ivanshalashilin/Cavity/README.md

# Scanning transfer cavity lock MSci project
## Ivan Shalashilin and Jacob J. J. Edginton

Writeup tutorial and code of how to use the scanning transfer cavity lock (STCL) for the next
set of students. This readme outlines important knowledge 

# Experimental setup

The STCL setup is as follows (parts list at the end):

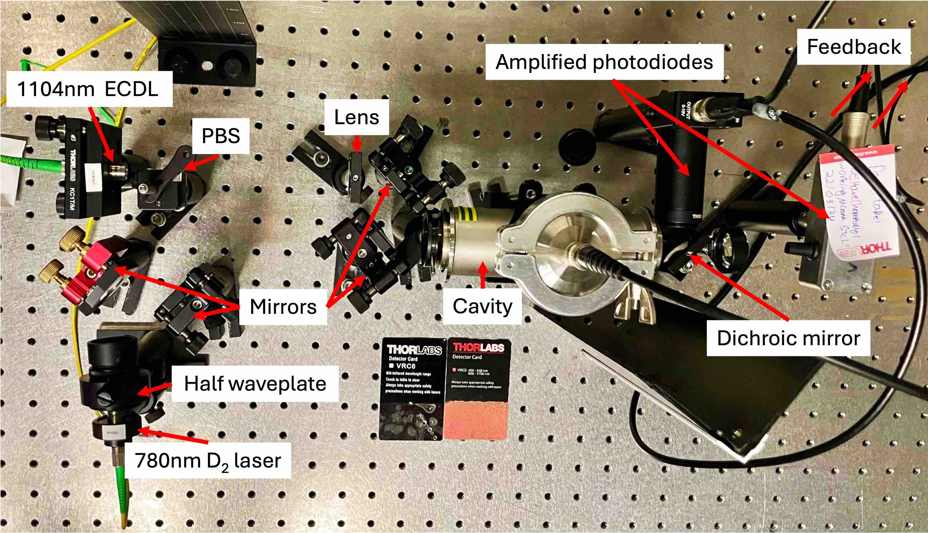
[picture p1: assets/cavity_setup_annoted.jpg]


0. Set up the optics as in the diagram (except the dichroic)
1. Fibre light from 1104nm and 780nm into fibre collimators
2. Pass 780nm light through half waveplate. Rotate waveplate until it is reflected at the
   polarizing beam splitter (PBS)
3. Turn on function generator, amplify the signal, and scan the cavity with a
   sawtooth/triangle wave at $\sim$ 5-15Hz
4. Couple 1104nm into the cavity (alignment tips below), until signal is maximized. Monitor output with amplified
   photodiode on an oscilloscope
5. Align 780nm into the cavity via the PBS
6. Align dichroic mirror and second photodiode to split 780nm onto the second channel

# Peak detection

Once both lasers are aligned, the peak detector boxes need to be set up - these provide
a TTL (digital) pulse for use in locking. This is done as follows:

1. Send each photodiode output into a separate peak detector box
2. Plug preamp monitor and output into scope, adjust the box until signal is desired
   (this step is finnicky)
3. Repeat 2 for diff gain and threshold
4. Change pulse width to desired value (see below)

The schematics/circuit diagrams for the peak detector boxes are available in the CCM.

## Arduino

The Arduino Due takes 4 digital inputs - TTL 780nm, TTL 1104nm, rising and falling edge of
function generator scan trigger. There are two digital outputs for feedback to the cavity and
the laser. The Arduino is set up as follows:

(pin values are arbitrary. Choose whatever corresponds to the code/is convenient)

1. Connect the 780nm TTL into pin 50 and the 1104nm TTL into pin 46
2. Split the function gen trigger signal and connect to pin 30 and pin 26
3. Connect the 1104nm feedback to DAC0 and the cavity feedback to DAC1
4. Connect low pass filters (cutoff $\sim$ 1000 Hz) on the analog outputs
5. During operational STCL, combine the amplified function generator and cavity feedback with the
   voltage summer, then send to cavity
6. Adjust offset on function gen until the cavity is scanning a FSR with an 1104nm peak in
   the middle of two 780nm peaks
7. Run Arduino code

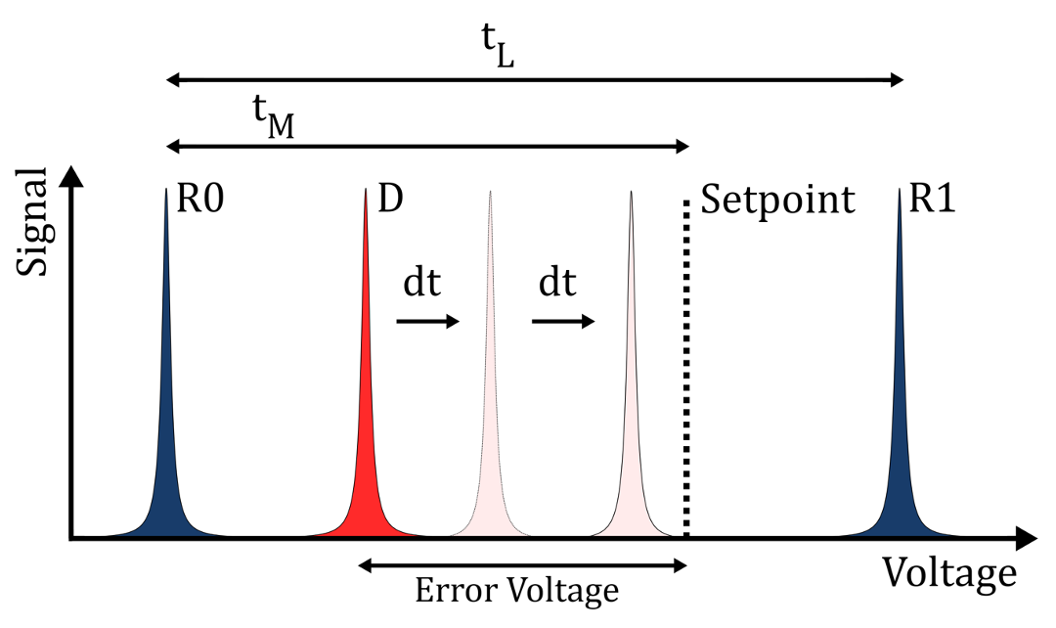
[picture p2: assets/STCL_algo_cartoon.png]


# Arduino algorithm

## High level

Check this paper for a good explanation: [Fast scanning cavity offset lock for laser frequency drift stabilization](https://pubs.aip.org/aip/rsi/article-abstract/81/7/075109/924409/Fast-scanning-cavity-offset-lock-for-laser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)

## Code specifics

This repo contains the STCL file `STCL_CCM_final.ino`, which works as follows:

  `setup()` 
  - 
-  Enables output to the analog pins
-  Enables the serial port for data logging
-  Creates interrupt pins for the rising and falling scan trigger edge 
- Enables the input to digital pins for 780nm and 1104nm
- Updates `time_previous` to the current time using `micros()`

`enable_input()` and `disable_input()`
  - 
- Interrupt functions associated with the
  rising and falling edge scan trigger - flip bools in the main loop 

  `loop()`
- 
- The loop begins by waiting until the rising edge, triggering `enable_input()`, which enters into the state
    machine `on_ttl_high`
- The code enters `while(!master_1_found)`, which continuously reads the master pin
    and stays inside the while loop until there is a high signal on the master pin. Once
    this is true, it records the time and flips the bool `master_1_found`
- Previous step is repeated with the bools `slave_1_found` and `master_2_found`

- Once all 3 peaks have been found, the code computes a PID 1104nm laser feedback (see theses for a
  detailed explanation)

-  Next, the code waits for the falling edge interrupt, and computes the cavity PID
   output. Both are then sent at the same time on the
  analog pins to the cavity and 1104nm laser. 

  - The loop resets and waits for `enable_input()`

If a peak is missed on the scan, the Arduino loops over the pin until `disable_input()`
is triggered, resetting the loop entirely, and no correction
is made.

# Alignment

Aligning a cavity is an art, not a science. Here are some tips:

1. Place the alignment mirrors as close as possible to the cavity
2. Always use a lens, *before* the alignment mirrors. This way changing the alignment
   doesn't mess with alignment along the lens
3. Use q-parameter software such as GaussianBeam to determine where the lens should go,
   accounting for the first cavity mirror
4. Centre the mirror threads before alignment
5. Coarsely adjust into the cavity by manually moving/rotating the mirrors before using
   the threads
5. Ensure the beams are central on the face to avoid clipping
6. Always lens the signal onto the photodiode

In his thesis, John Barry mentions an iterative method of aligning which involves
changing the mirror length. We didn't do it this way but reading his thesis may be useful.

# Data acquistion (DAQ)

Data logging was used extensively in the project. To monitor cavity signal, we used a
PXIe and NI DAQs interfaced by Labview. This is found in the folder `Labview`. The PXIe has a breakout board with many pins, the board guide that matches up the names of the physical pins and the physical channel names you'll see in LabView is available from [NI's website](https://www.ni.com/knowledgebase/attachments/A1866E353248893C862571BD000CEB62_SCB-6820653X.pdf).

(note for Jacob: write up Putty + Labview)

## LabView Program

To collect photodiode voltage and Thermocouple temperature a custom built LabView software was created. To avoid large files and memory overflow the program saves collected data periodically in separate files rather than in one file all at once. 
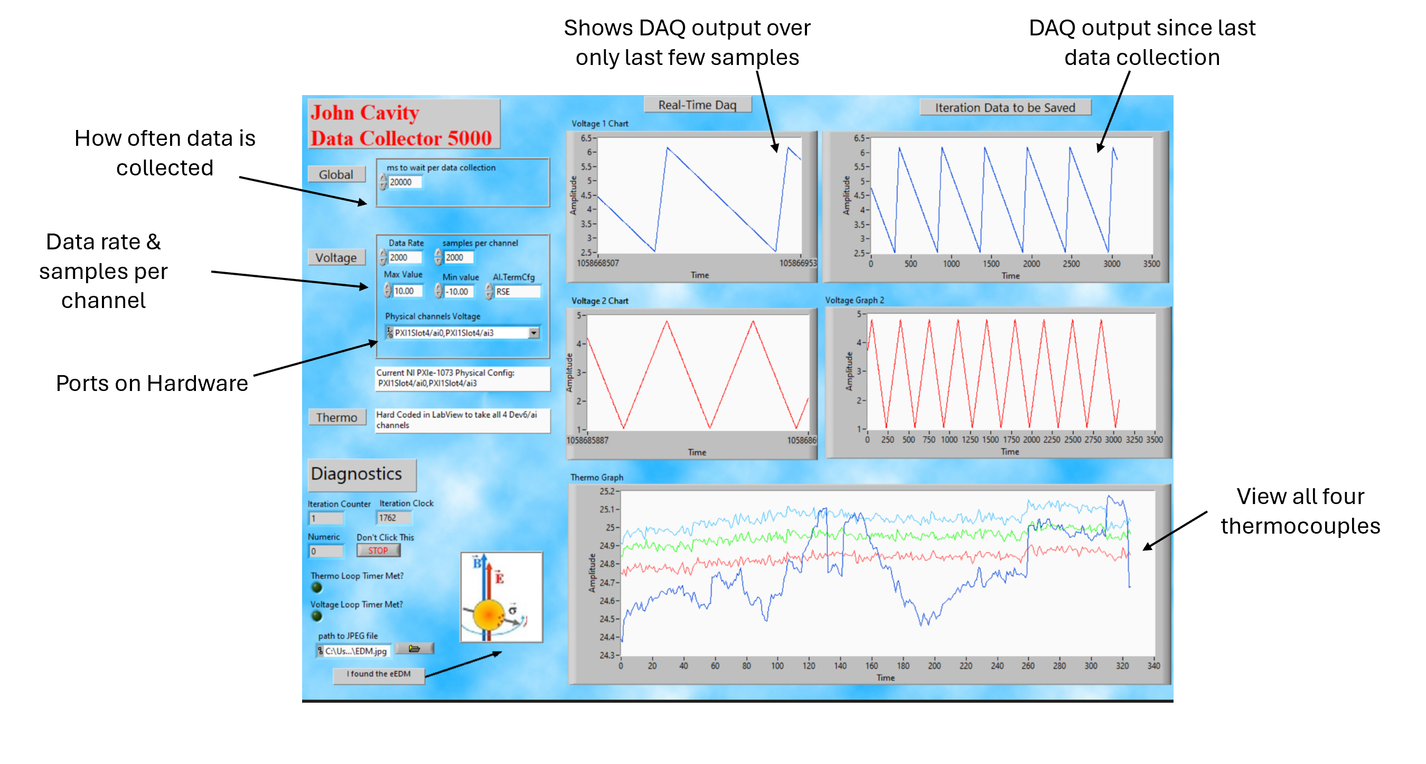
[picture p3: assets/LabViewUI_labels.png]

The above image shows what the UI for the program looks like during operation. To set up data collection:
- Choose two PXIe physical channels to view/record. Typically for the STCL this is the function generator and the photodiode.
- Set the desired length in milliseconds between data collections.
- Set the `Data rate` and `samples per channel`. Making the rate too high can cause issues with the signal.
- Generally always leave the max/min at 10/-10 and the `Al.TermCfg` to `RSE`. 
- When you first run the code you will be prompted to add an image. Adding any image file will work (this is a deprecated part of the code and should be removed).
- The iteration counter keeps track of how many times the data has saved.
- The file paths to save the photodiode voltage and thermocouple temperature txt **must be set manually** in the LabView code. 

General notes about the LabView software:
- There are no settings for the thermocouples as these were set manually in the LabView code. They may be changed by editing the code directly. 
- The "Current NI PXIe-1073  Physical Config" is an old placeholder (may be ignored).
- This code is quite rudimentary. If all you want is photodiode/temperature data it will work but we would recommend building a new program in LabView from scratch that is more optimized (this one uses a double for loop...)

## Putty
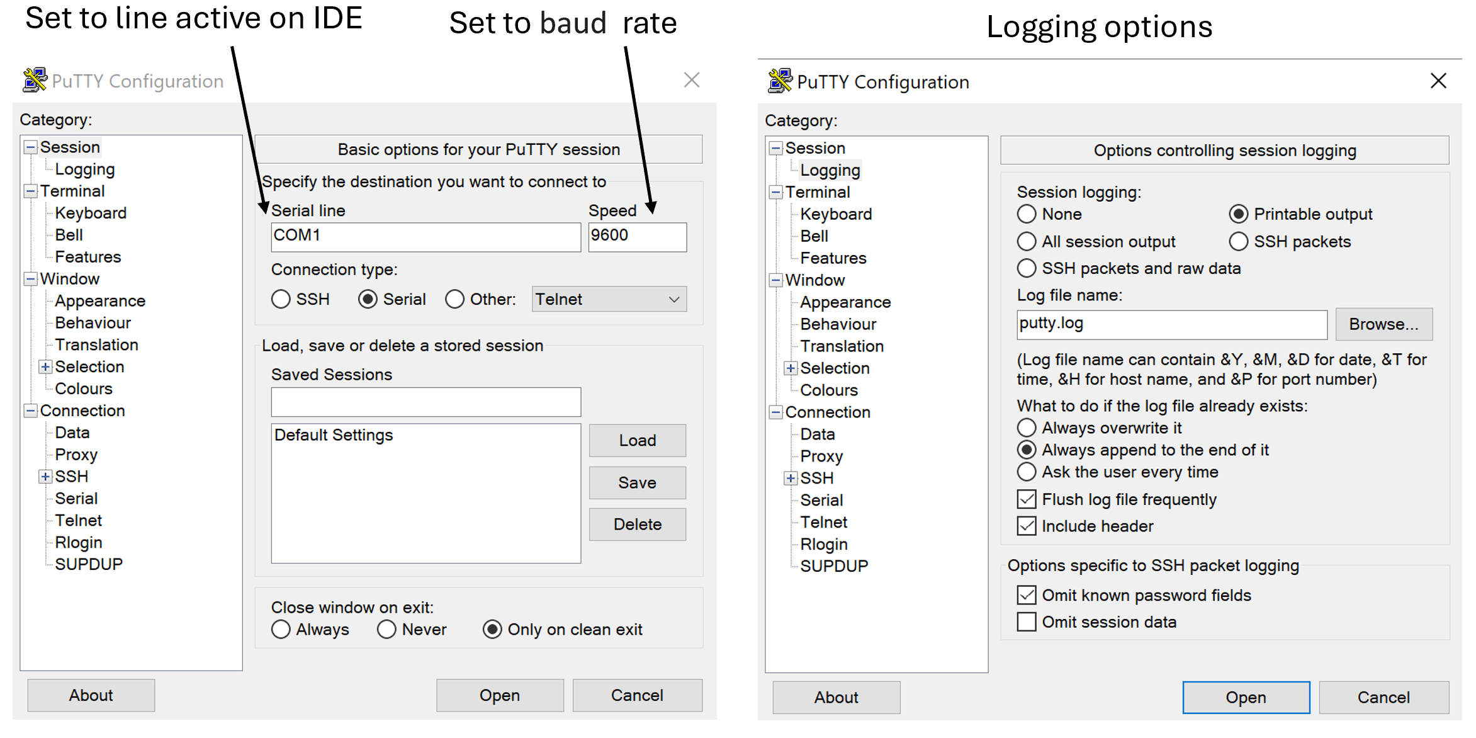
[picture p4: assets/putty.png]

To collect data from the Arduino Due (e.g. times of peak detection) we used the software Putty, available for [download online](https://www.putty.org). The Arduino must be plugged into the computer for Putty to work. We recommend using the official [Arduino IDE](https://www.arduino.cc/en/software) whilst trying to log data. The process for logging is as follows:
- Specify the COM line and baud rate in Putty (this information will be visible in the Arduino IDE).
- Set logging settings (location, name, etc.)
- Begin Putty session.
- Activate Aruino code.

# Electro optical modulator (EOM)

Throughout the project we used an EOM to determine the cavity nonlinearities and
concluded they are a material property of the PZT. There is currently an EOM on our
bench with a resonant frequency of 94.9MHz that can be inserted between the PBS and
lens. We used a vector network analyser to determine the resonant frequency which can be
found in Blackett. The EOM is driven by a voltage controlled oscillator (VCO) amplified
by an RF amp.

# Improvements

With our setup the 1104nm stayed lock for 1.9 days with a spread of 1.6 MHz, and there
are plenty of areas for improvement:

- **Amplified photodiode**: The transmission on the current cavity mirrors is low, even on resonance (James Almond [PhD Thesis](https://www.imperial.ac.uk/centre-for-cold-matter/publications/theses/) 2017 page 94, footnote 11). We found that a reliable signal for STCL was only possible with amplified photodiodes. 

- Hardware interrupts: Currently the peaks are found by continuously looping over the
  pins. Instead, the peak detection needs to be done with a hardware interrupt,
  effectively increasing the detection resolution, and allowing for more corrections per
  second. Our current setup only optimally allows for correction speed of $\sim$ 5Hz, even though
  we were driving the cavity at 15Hz. With interrupts, we believe this could go $\sim$ 100-1000Hz

- The data types in the code are **not set correctly to save putty data**. This does not prevent the STCL from running. The variables that are initialized as `unsigned long` should be changed to another type e.g. `double`.

- Auto initialization: The function generator DC offset needs to be manually adjusted
  for the correct locking configuration (780nm-1104nm-780nm). A better method would be to scan
  the offset to find an ideal configuration and determine the setpoint from there.

- Peak detector TTL output: the peak detector boxes take all the photodiode signal, so it can't be
  split to observe on both the photodiode and the scope at the same time. Maybe some
  resistors are needed.

- **Different cavity mirrors**: the cavity mirrors (Layertec 103950), which make a cavity
  with very low transmission, and has been studied before by James Almond ([PhD thesis](https://www.imperial.ac.uk/centre-for-cold-matter/publications/theses/) 2017,
  page 94, footnote 11)

- Dichoric mirror and PBS: the dichroic mirror has high absorption, significantly
  attenuating the 780nm reflected beam.
  
- Higher power: 0.4mW is passed into the cavity at 780nm. With a 50$\Omega$ input impedance the entire
  signal was attenuated which is not sufficient to
  perform a proper finesse calculation. Using a more powerful beam allows allows for
  smaller resistor

- Ringdown measurement: ask CCM member Jonas for more information. We attempted this but didn't have enough
  power/the AOM was not quick enough (unsure). See [AOM](/assets/project/AOM.png) for the experimental set-up we tried. 

- ECDL feedback: in our setup we used an amplifier to send the feedback signal to the
  ECDL, which ended up being our main source of error. This can be removed, and was only
  used as a proof of concept to scan a larger range in frequency space.

- Peak detector box accuracy and variance: the output TTL has a large variance and a
  systematic shift from the true peak centre. This should be characterized and
  investigated.
  
- Peak detector box issues: 10mV noise on the output and grounding issues

- New cavity: The current cavity quartz is cracked, and possibly not the right length.
  We cut and glued a new one but maybe used too much glue inside the cavity, meaning the
  thermal compensation won't work properly

- Hermetic seal: we believe the seal may be slightly leaky, which according to John
  Barry leads to a drift of many, many FSRs.

- Laser locking: during long-term (3 days +) runs to establish thermal performance the laser may unlock. This makes it difficult to seperate thermal drift from laser drift. Ensure the laser is locked before taking thermal data.

- Applying heat: we applied heat as a step change (e.g. 10 degrees). It may be more useful to step the temperature in small increments instead.  

# Parts list 

## Cavity
 
- Cavity mirrors - [Layertec laser mirror 103950](https://www.layertec.de/en/shop/datasheet-103950/?cur=USD)
- KF-50 vacuum casing
- PZT actuator – [Noliac NAC2123](https://www.mmech.com/images/stories/Standard_Products/Noliac_Actuators/Ring_Actuators/NAC2123.pdf)

## Electronics

- Voltage summer (homebuilt)
- Function generator
- Amplifiers
- Lowpass filters (homebuilt)
- Electro optical modulator (EOM, homebuilt)
- Arduino Due microcontroller
- PXIe data acquisition box
- **Amplified** photodiodes x 2 
- Peak detector boxes (homebuilt, find these in Blackett bay 1)

## Optics

- 780nm D2 Rb laser
- 1104nm ECDL laser
- Broadband mirrors x 4 – [Thorlabs BB1-EO3](https://www.thorlabs.com/thorproduct.cfm?partnumber=BB1-E03)
- Fibre collimtors x 2 – [Thorlabs
  F280APC-C](https://www.thorlabs.com/thorproduct.cfm?partnumber=F280APC-C) (one of them
  may be B coated rather than C)
- Polarizing beam splitter
- f=150mm B coated lens (subject to change) – [Thorlabs LA1433-B](https://www.thorlabs.com/thorproduct.cfm?partnumber=LA1433-B)
- Half waveplate
- Dichroic mirror – [Thorlabs DMLP950](https://www.thorlabs.com/thorproduct.cfm?partnumber=DMLP950)
- Lenses for photodiodes (short focal length) x 2  

## Thermo 

- Varyac (find these in Blackett)
- Thermocouples
- NI Thermocouple DAQ
- Insulating foil

# Thermal
See the page [Thermal](Thermal.md) for detail on the thermal characterization of the cavity. 

# Misc.
If you would like any additional information of access to the data please contact the authors or the CCM.
