ivanshalashilin/Cavity/assets/LabView_UI.JPG

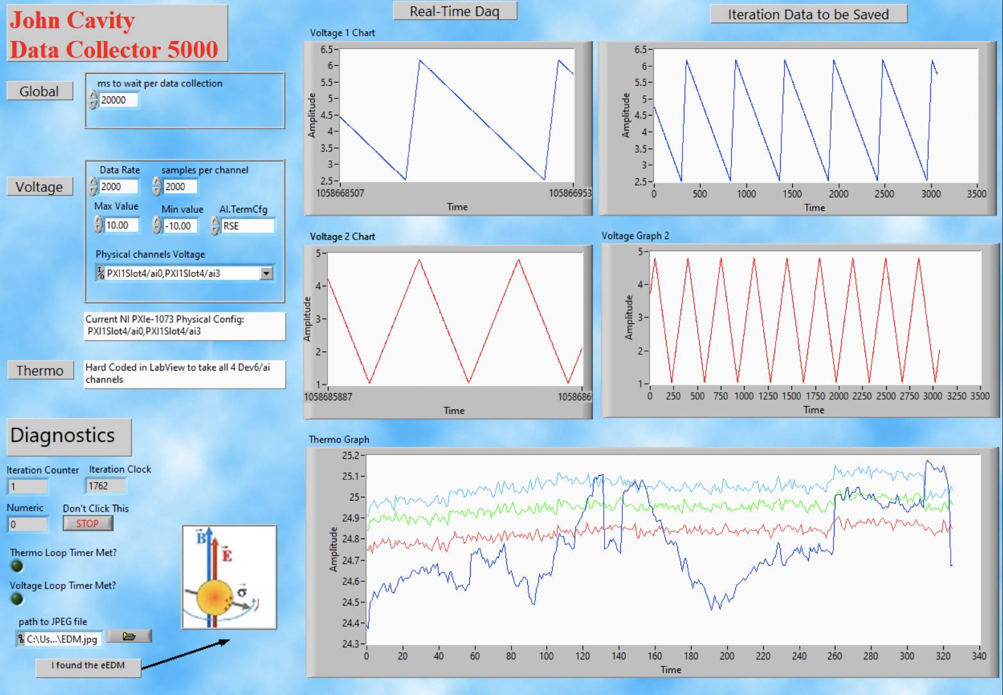
assets/LabView_UI.JPG
