ivanshalashilin/Cavity/assets/project/AOM.png

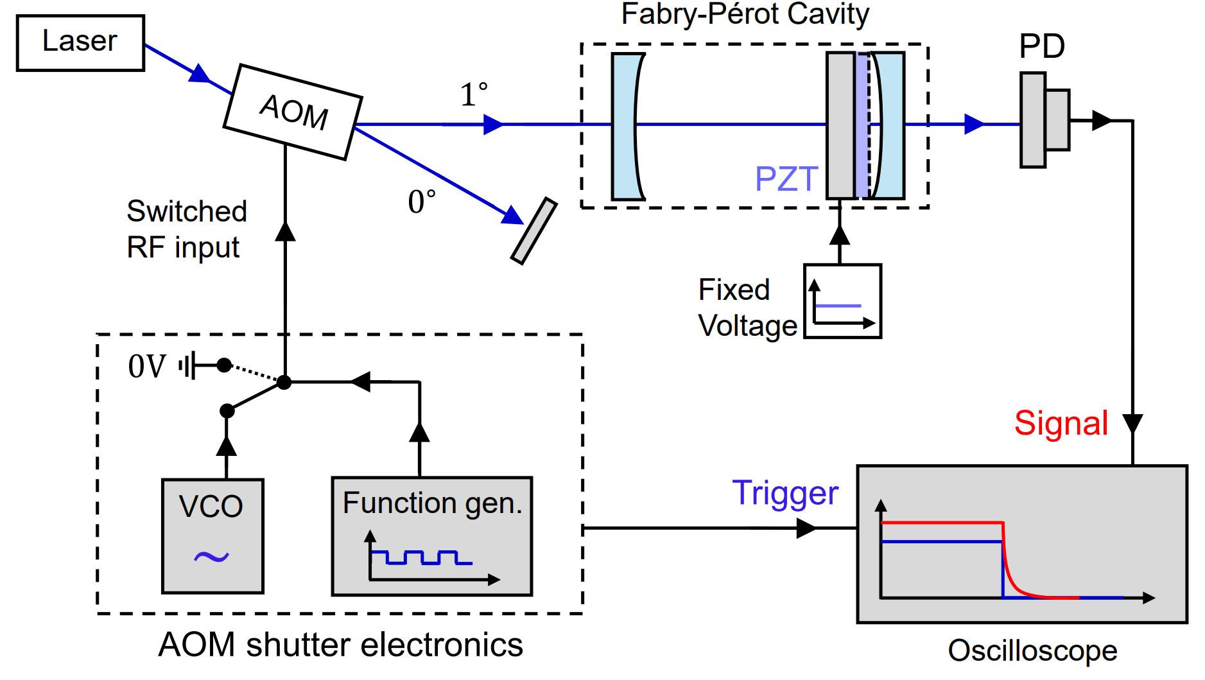
assets/project/AOM.png
